sivakov512/kicad-library/(commit log)

2025-04-17 Commit them all initially
    [5V - 3.3V.kicad_sch, AC -> 5V (HLK).kicad_sch, FuseHolder_THT_5x20mm_PTF76_RM15mm.step, Relay_SPDT_Relpol-RM51.stp]
2025-04-20 Add datasheet link to Relay_SPDT_Relpol-RM51 footprint
2025-04-27 Rename HLK design block to include model number
    [AC -> 5V (HLK-5M05).kicad_sch]
2025-04-27 Add LNK306P-based AC to 5V design block
    [AC - 5V (LNK306P).kicad_sch]
2025-05-01 Add datasheet and update footprint for Relpol RM51 relay
2025-05-01 Add VIPER06 component with symbol, footprint, and 3D model
    [VIPER06_SSO10.step]
2025-05-04 ESP32-H2 synbol and datasheet, TQFN-32-1EP footprint and 3d model
    [TQFN_32_1EP_4x4mm_P0.4mm.step]
2025-05-08 Add a lot of new components
    [AH316M245001_T.step, Relay_SPST_OJ_SH_105HM_000 .step, Wurth_750370423_THT_E13.step, fuse_2410_6125metric_6.1x2.5mm.step]
2025-05-22 Reogranize project into more KiCad traditional way
2025-05-22 Drop design blocks, cause they are too individual
    [5V - 3.3V.kicad_sch, AC - 5V (LNK306P).kicad_sch, AC -> 5V (HLK-5M05).kicad_sch]
2025-05-27 Add KiCad project files and library tables
    [kicad-library.kicad_pcb, kicad-library.kicad_sch]
2025-05-27 Add test point footprint for 2-pad 2.54mm configuration
2025-05-28 Make silkscreen and fabrication layers easier to understand
2025-05-28 Add 2.54mm pin headers footprints with no silkscreen
2025-05-29 Fix esp32-h2 symbol layout
2025-05-29 ESP32-C3 symbol
2025-05-29 Added footprint and 3d model for smd1612 crystal
2025-06-01 Add 1x02 pin header footprint without silkscreen graphics
2025-06-01 1x07 pin header footprint without silk screen graphics
2025-06-05 Add VFQFN-32 footprint with 3D model
2025-06-09 Fix esp32-c3 front mask and paste layers
2025-08-02 Add 6mm tactile switch footprint to library
2025-08-12 Fix vfqfn footprint
2025-08-18 Add WaveShare ESP32-C6-Zero dev board with 3D model
2025-08-25 Fix devkit footprint
2025-09-14 Add radial electrolytic capacitor footprints
2025-09-14 Add SOD-64 THT diode footprint
2025-10-20 Fix SOD-64 pin names
2026-02-19 feat: Add Quectel YC0010AA antenna footprint, 3d model and datasheet
2026-02-19 feat: Cvilux CU3216SASBLR004-NH USB-C Receptacle footprint and datasheet
2026-02-20 feat: Add Rohm BDXXKA5WF fixed regulator family
2026-04-02 feat: footprint for hybrid no name usb-c receptacle
2026-05-10 refactor!: restructure library to conform to KLC v3.0
    - Rename all library dirs/files to singular KLC-compliant names (SKC_Relay_THT, SKC_Package_QFN, etc.)
    - Add vendor prefixes to all footprints and symbols (e.g. WaveShare_ESP32-C6-Zero, TE_OJ-SH-105HM_SPST)
    - Rename SKC_DevKit_WaveShare → SKC_DevKit to avoid vendor duplication
    - Use LOCAL_SKC_* in lib-tables (avoids conflict with PCM-installed plugin) and PCM_SKC_* in component Footprint properties
    - Standardize datasheet and 3D model paths to match new directory structure
    - Update README with separate Symbols and Footprints tables matching actual library structure
    - Remove CONTRIBUTING.md; add Structure section with KLC reference
    [kicad-library.kicad_pcb, kicad-library.kicad_sch]
2026-05-10 feat: added datasheet for TE_OJ-SH-105HM_SPST relay
2026-05-10 feat: SK6812-EC20 symbol, footprint, datasheet
2026-05-10 feat: TPS212x symbol, footprint, 3dmodel, datasheet
2026-05-10 feat: DRV8316C symbol, footprint, datasheet, 3d model
2026-05-10 feat: MAX17048 symbol, footprint, datasheet, 3d model
2026-05-10 feat: ZMPT101B symbol, footprint, datasheet
2026-05-10 feat: A7672X/A7670X symbol, footprint, datasheet, 3d model
2026-05-10 feat: PJ-3126-5A footprint and datasheet
2026-05-10 feat: KLJ-5020 footprint and datasheet
2026-05-10 feat: BH-18650-A5BJ001-2D footprint and datasheet
2026-05-10 feat: MOLEX_475532001 footprint, datasheet, 3d model
2026-05-10 feat: MMPC0402 footprint and datasheet
2026-05-10 fix: drop footprints for pinheaders and nettie
2026-10-01 fix: mark WaveShare_ESP32-C6-Zero power pins as bidirectional
2026-10-12 fix: pin datasheet links to the release tag in PCM packages
2026-10-13 fix!: migrate all libraries to KiCad 10 format
2026-10-13 fix!: bring symbols and footprints in line with KLC
2026-10-13 refactor!: rename symbols, footprints and datasheets per KLC
2026-10-13 refactor!: drop unused CP_Radial D5/P1.5 and D16/P10 footprints
2026-10-13 fix: round non-pin-1 THT pads, KLC exception for Cvilux USB-C
2026-10-13 fix!: listed pin stacks, 100mil pins, stock fields, A7672x GND
2026-10-13 refactor!: lowercase x for SIMCom footprint, Molex datasheet name
2026-10-21 fix: MAX17048G ALRT pin is open-drain, named per datasheet
2026-10-21 fix: B3FS-40xxP pad pairs are joined inside the switch
2026-10-21 fix: courtyards cover pads and body with 0.25 mm clearance
2026-10-22 fix: Omron B3FS-4000 symbols and footprints per plunger type
